muneebahmed26301/Mobile-Robot-for-Smart-Restaurants/assets/FYP - Final Defense_1.pptx

Mobile Robot for Smart Restaurants

Group Members:
Muneeb Ahmad
Ahmed Saeed
Mohib Ahmed
Muhammad Zakriya

Supervisor:
Dr. Uzair Khaleeq uz Zaman
Co-Supervisors:
Dr. Anas Bin Aqeel
A/P Kanwal Naveed

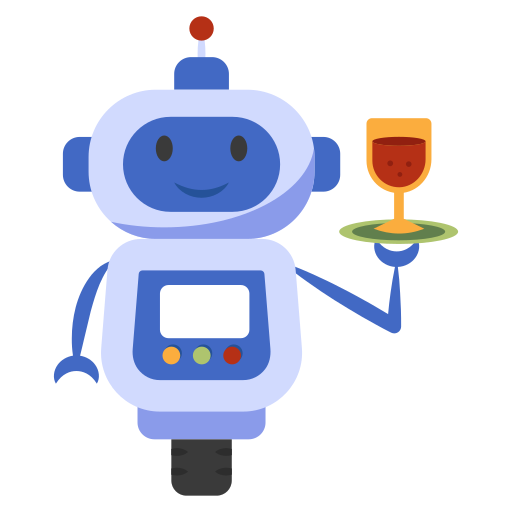
[picture p8: figure]

## Slide 2

Objective

To Design & Construct a Mobile Line Following Robot that Can Automate the Job of a Waiter In a Restaurant Environment

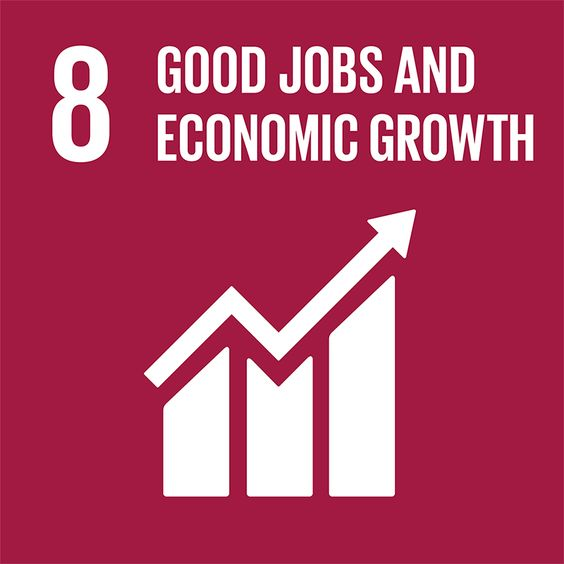
[picture p9: figure]
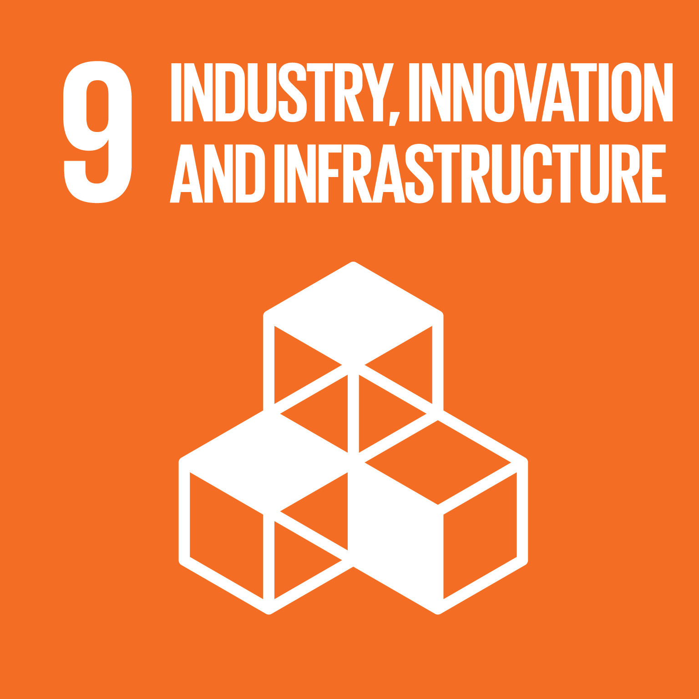
[picture p10: figure]
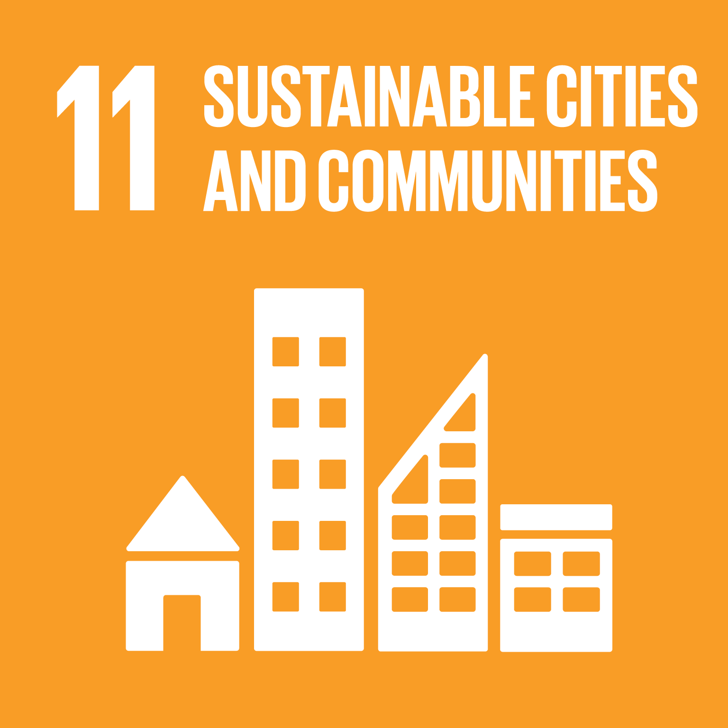
[picture p11: figure]

## Slide 3

The Problem

3.5 Trillion USD Global Restaurant Industry [1]

Labor Shortages[2] - Prime Target for Automation

Opportunities to Reduce Cost and Increase Profits[3]

Improved Customer Experience[4]

Ordering, Payment & Serving are the Easiest & Most Beneficial to Automate

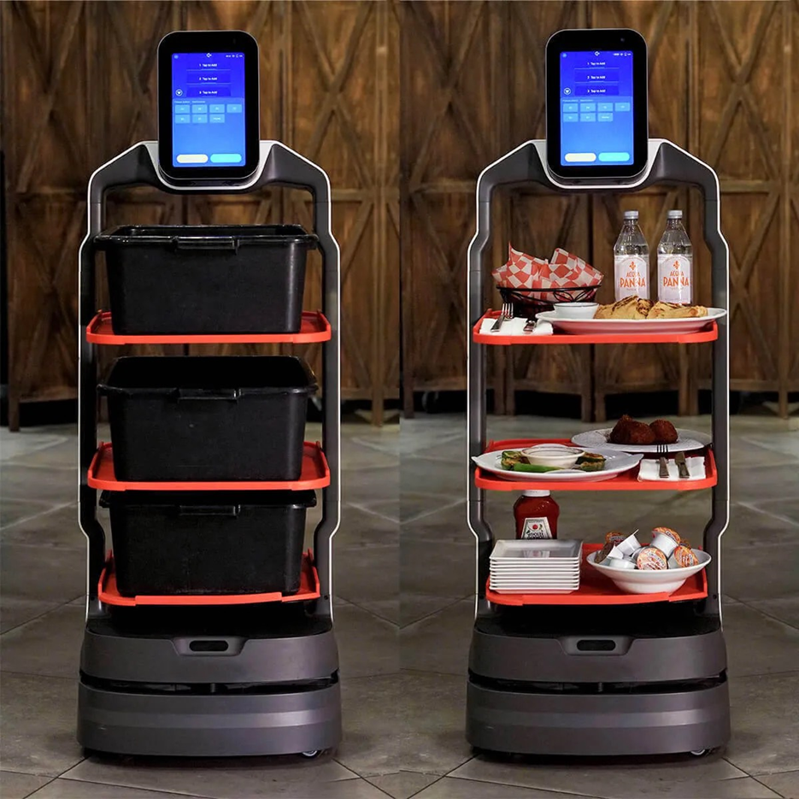
[picture p12: figure]

## Slide 4

Project Deliverables

1

Design & Build a Mobile Line Following Robot that is Able to Follow the Shortest path to a Destination (tables) and Avoid Collisions

Make it Capable of Carrying Load (Food & Drinks) without Spilling Them Using Quick Interchangeable Carrying Trays

Make it IoT Enabled so it can Send and Receive Data to and from Restaurant Staff

Ensure Ecosystem Integrability Through Software & Hardware Design as well as Industry Level Documentation

2

3

4

## Slide 5

Additional Accomplishments

5

Built An Ecosystem of Apps (Ordering, FoH Display, Remote Control) to Work Alongside the Robot as VAS

Studied Velocity, Acceleration & Braking Profiles to Ensure Robot Movement & Trajectory is Smooth and Safe

Used Cameras for Navigation Instead of a Sensor Based Approach; Enabled Robot to Map and Store the Restaurant Layout

Created a cloud Database for Restaurants to Digitize their Menus & Collect Valuable Trend Data

6

7

8

## Slide 6

Representative Environment

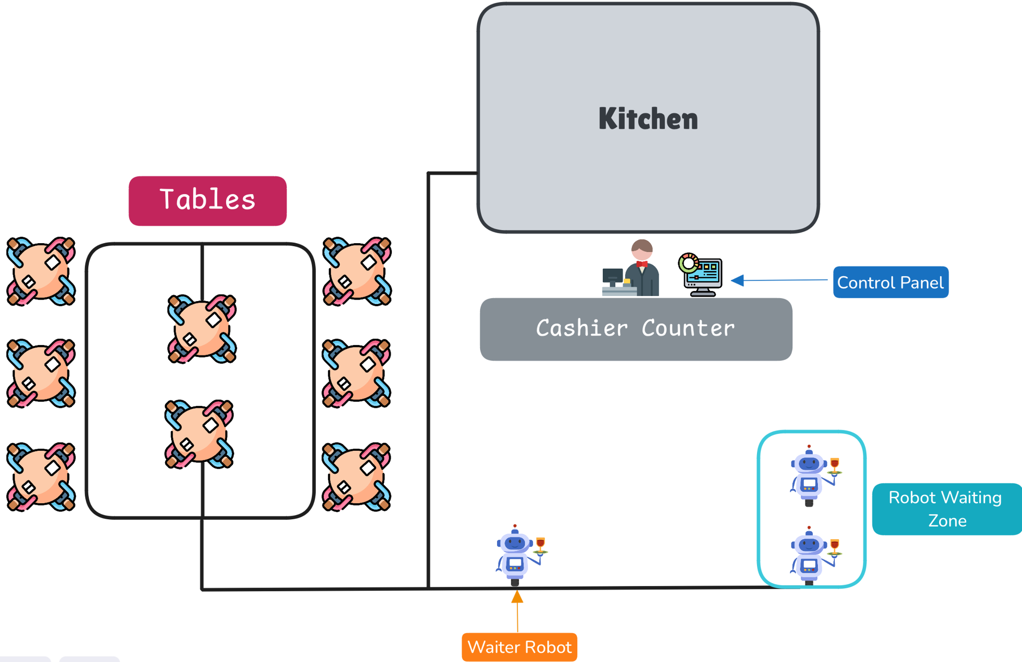
[picture p13: figure]

## Slide 7

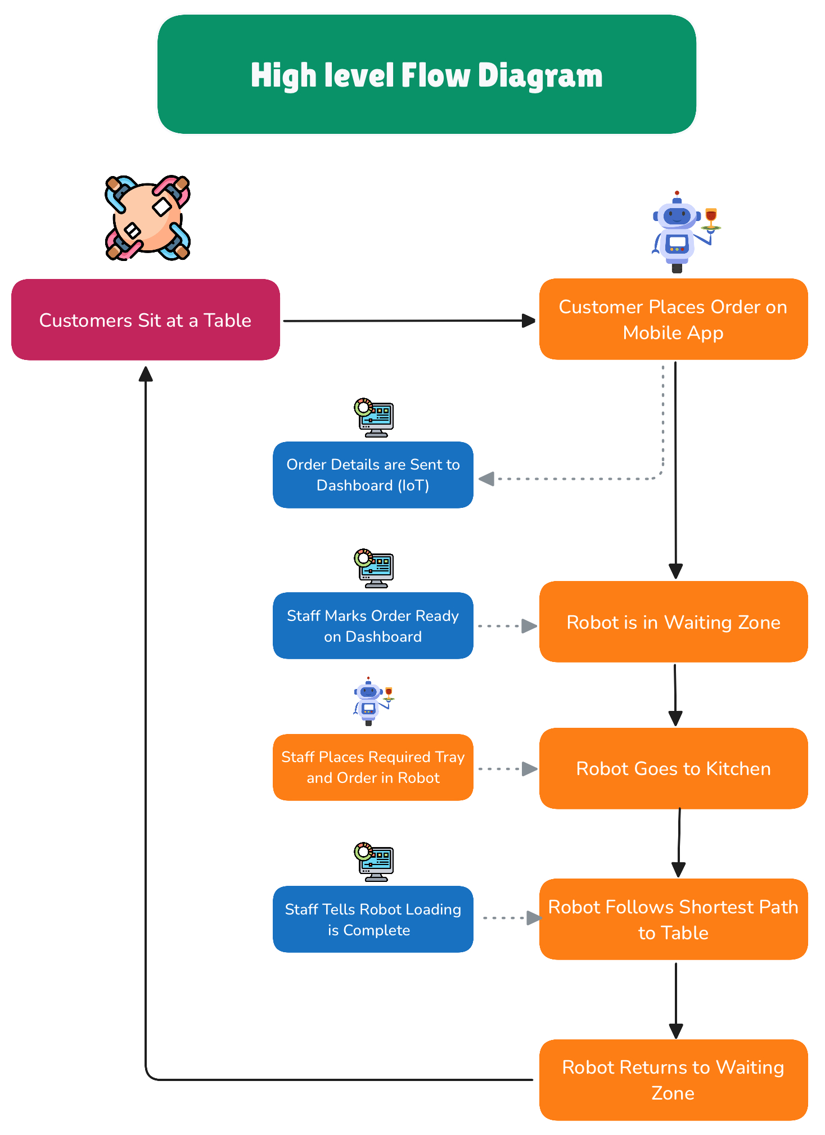
[picture p14: figure]

## Slide 8

Mechanical
Hardware

## Slide 9

Design Considerations

1

Based off Existing Designs

Design Factors Include Material availability, Safety, Cost, Strength/Load Carrying Capacity, Weight, Ease of Assembly and Aesthetics

Mechanical Simulations on ANSYS to Determine Materials & Parameters for Load Carrying or High Stress Parts

Modular Custom Parts and In House Fabrication & Assembly

2

3

4

## Slide 10

Existing Designs

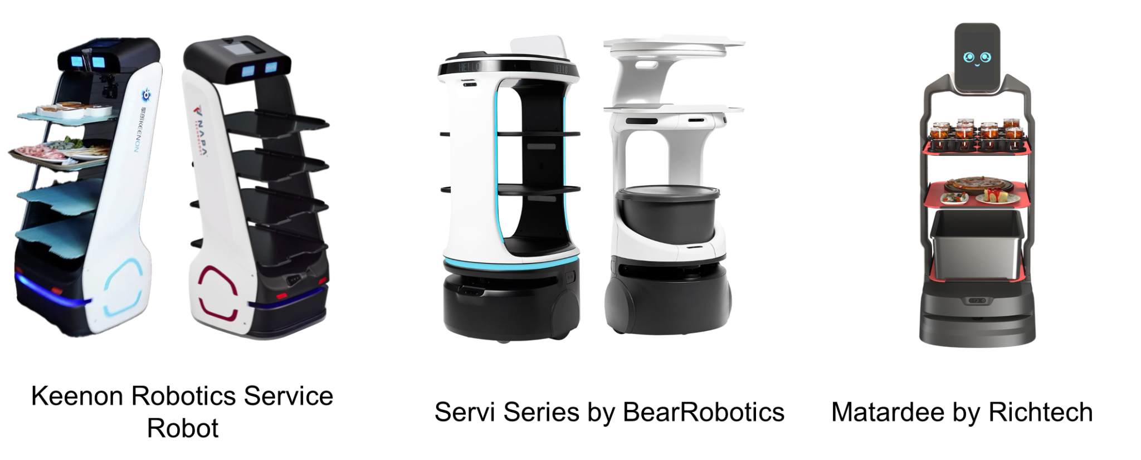
[picture p15: figure]

## Slide 11

Our Design

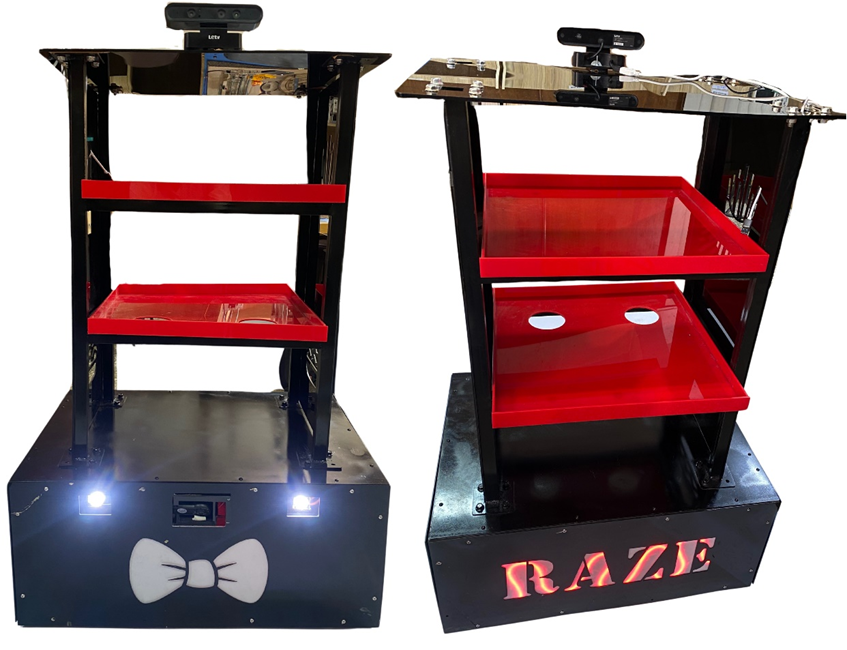
[picture p16: figure]

## Slide 12

Design Breakdown

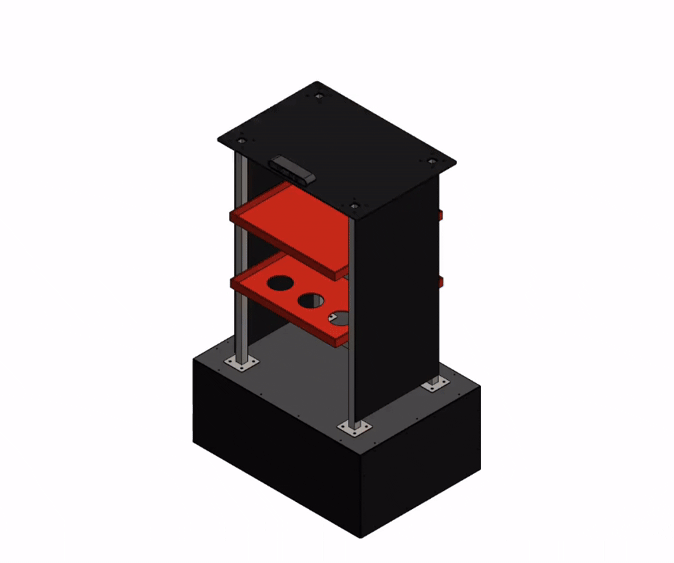
[picture p17: figure]

## Slide 13

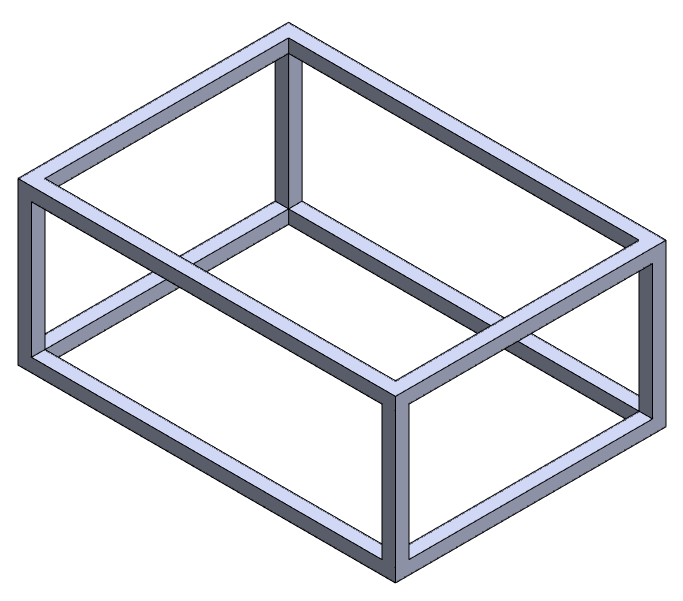
[picture p18: figure]
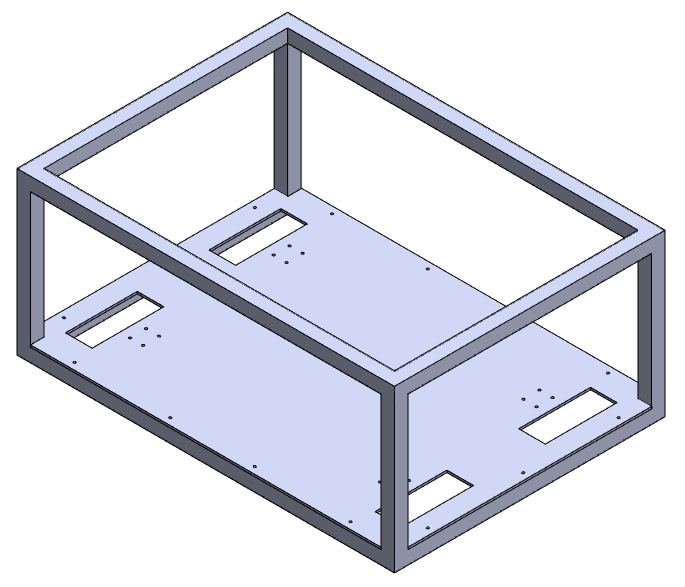
[picture p19: figure]
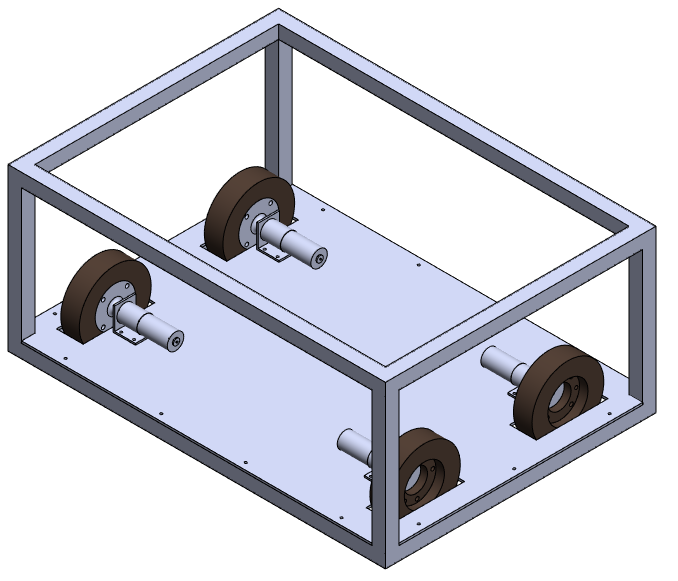
[picture p20: figure]
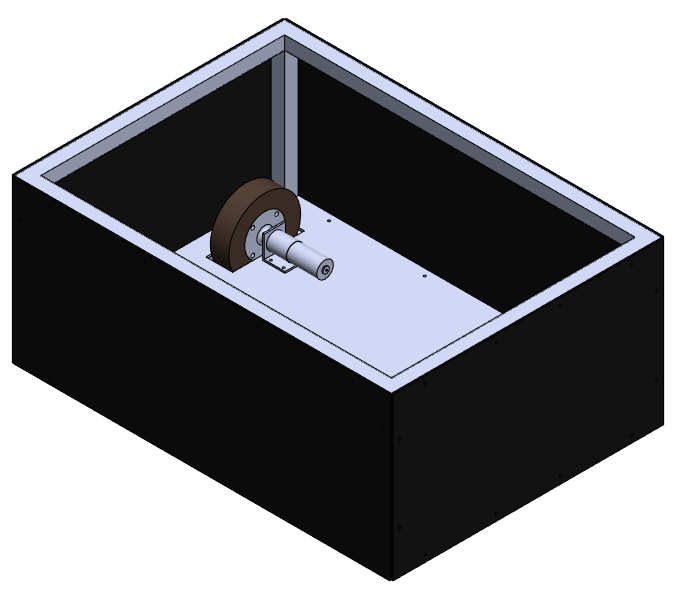
[picture p21: figure]
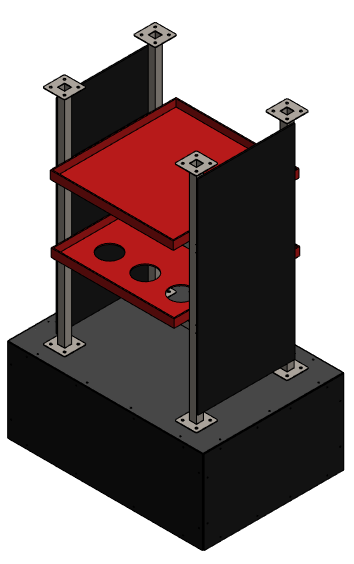
[picture p22: figure]
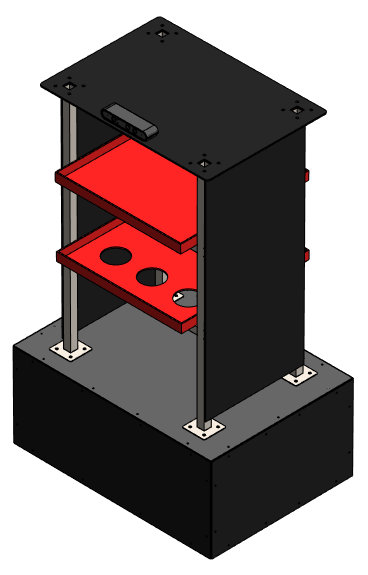
[picture p23: figure]
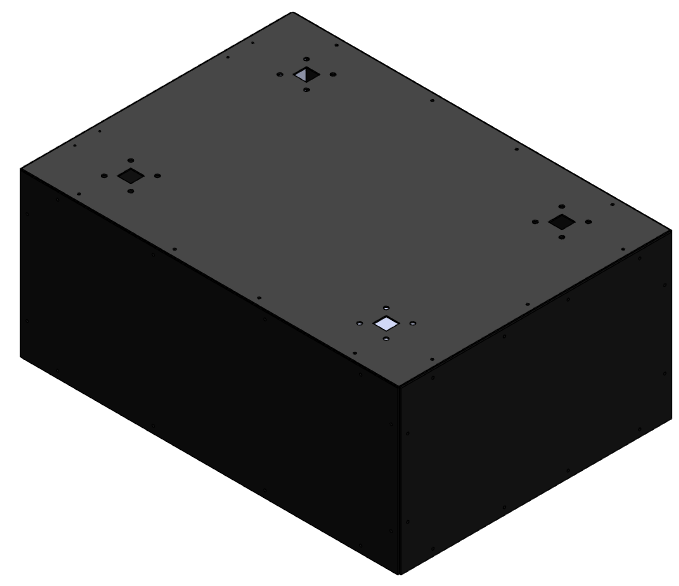
[picture p24: figure]
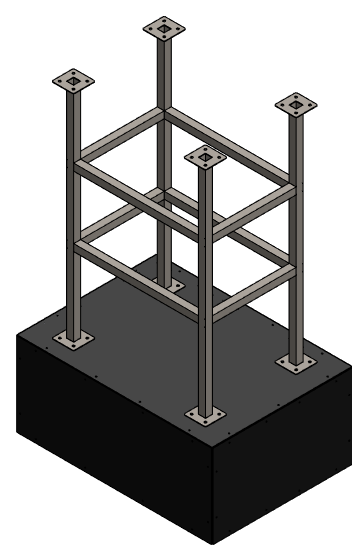
[picture p25: figure]

## Slide 14

Frame and Baseplate

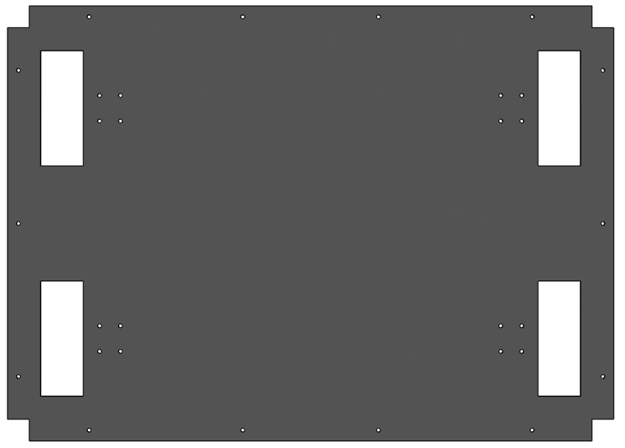
[picture p26: figure]
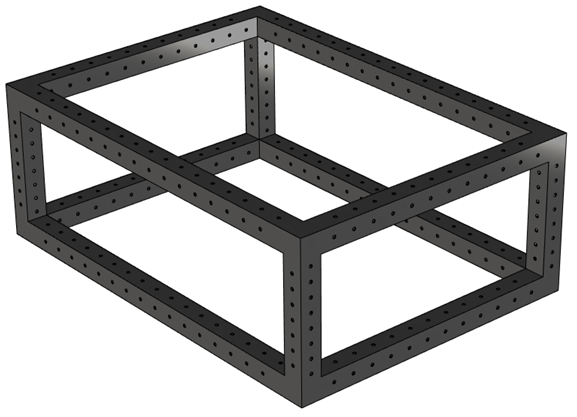
[picture p27: figure]

## Slide 15

Frame and Baseplate

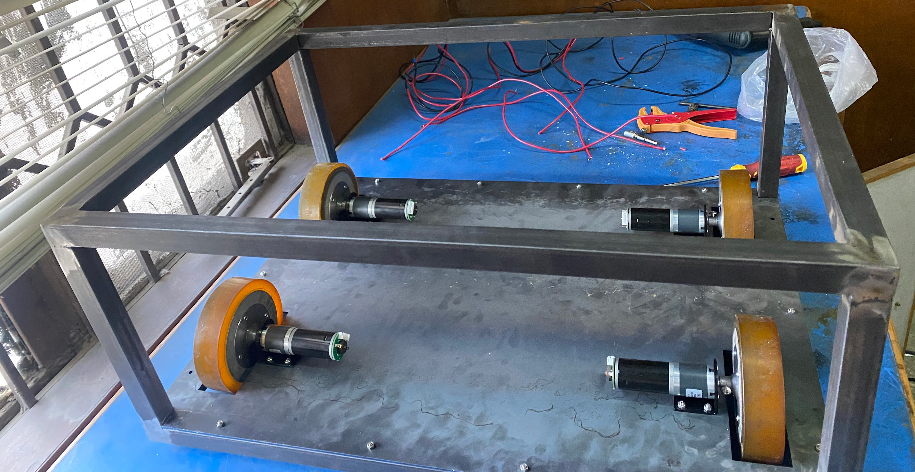
[picture p28: figure]
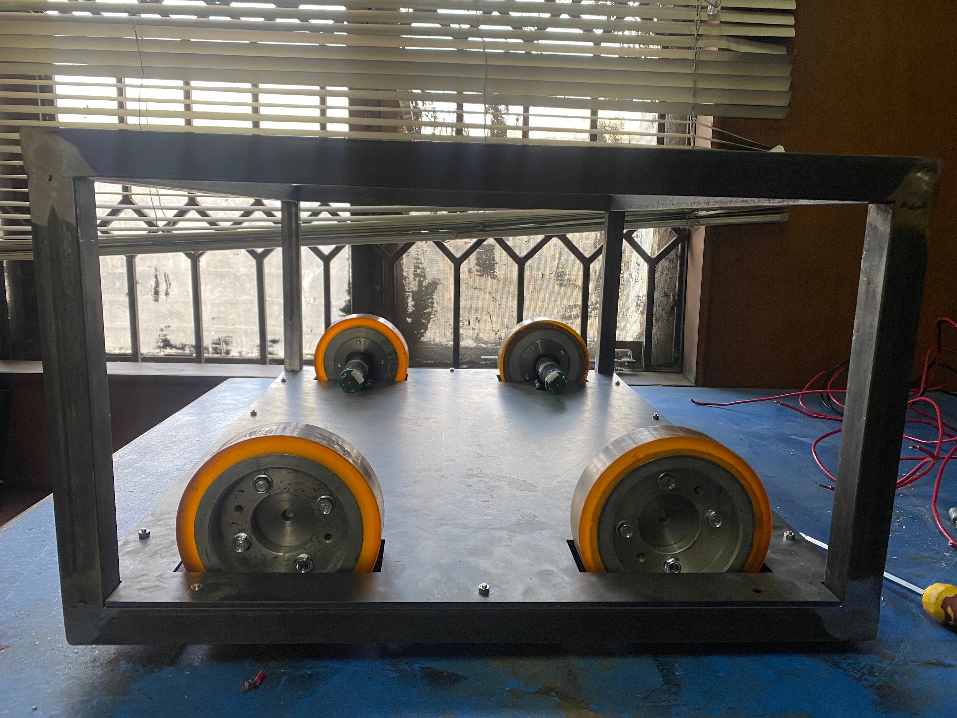
[picture p29: figure]

## Slide 16

Couplers and Wheels

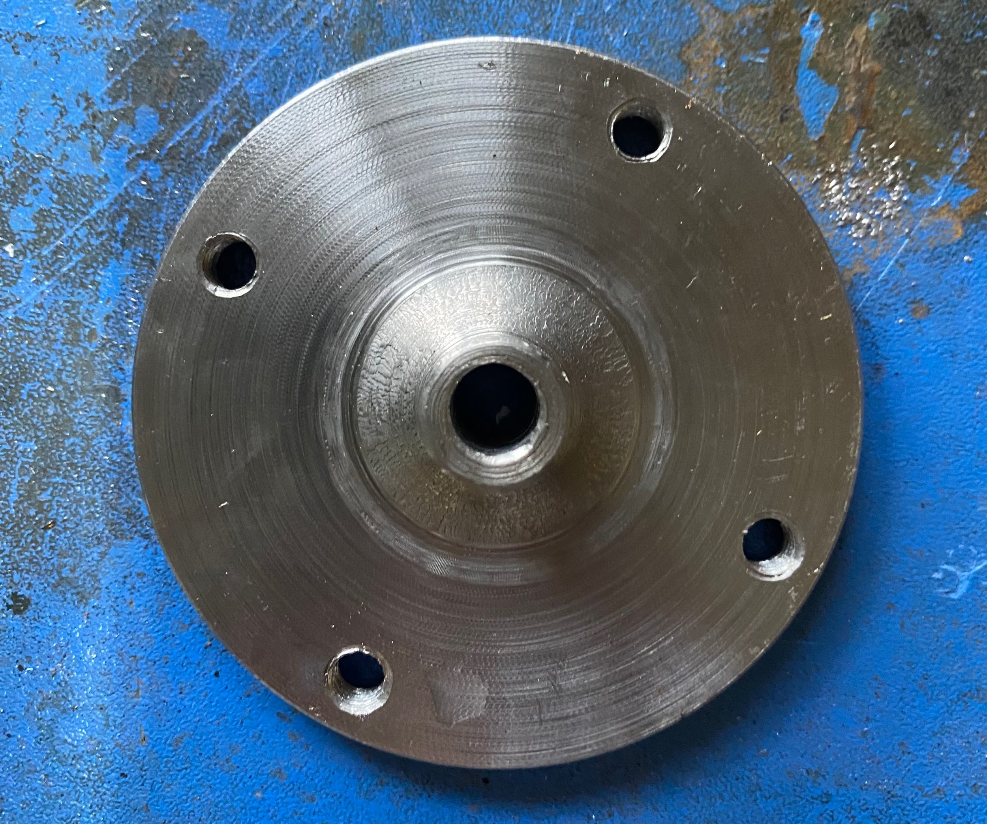
[picture p30: figure]
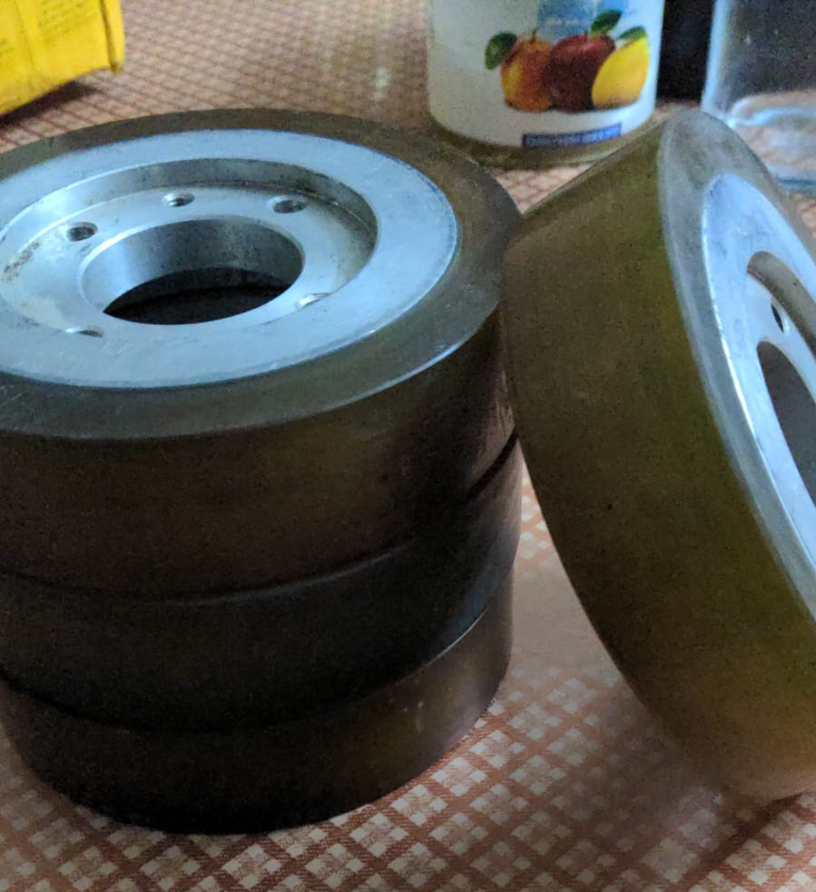
[picture p31: figure]

## Slide 17

Coupler Deformation

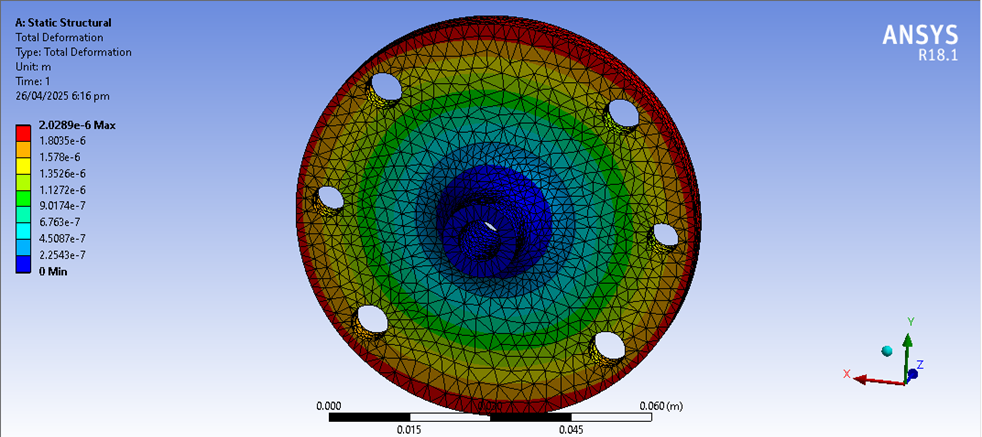
[picture p32: figure]

## Slide 18

Coupler Stress

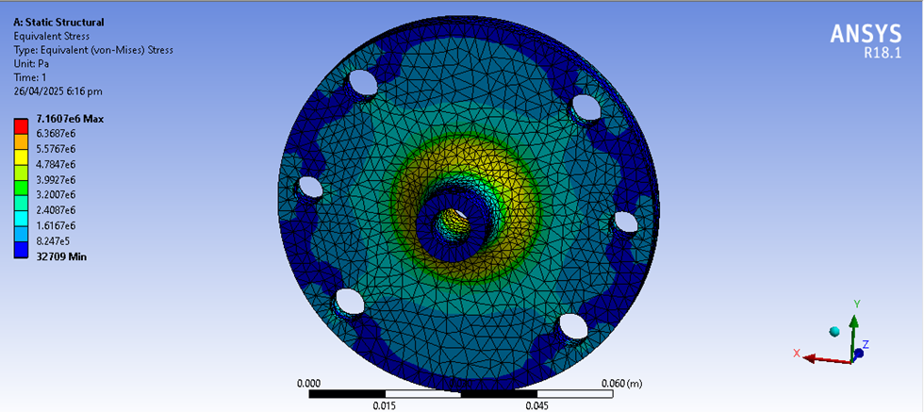
[picture p33: figure]

## Slide 19

Load Trays

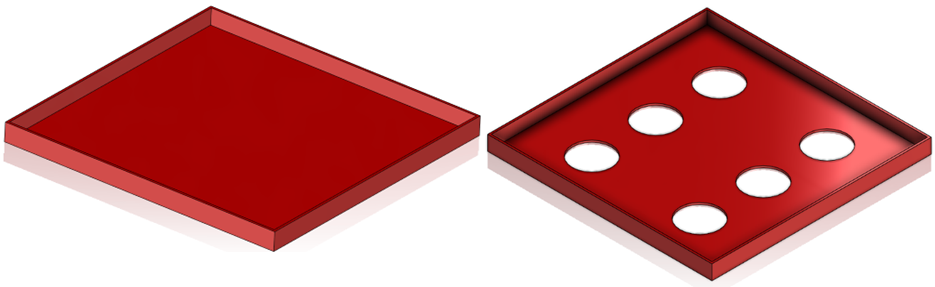
[picture p34: figure]

## Slide 20

Load Trays Deformation

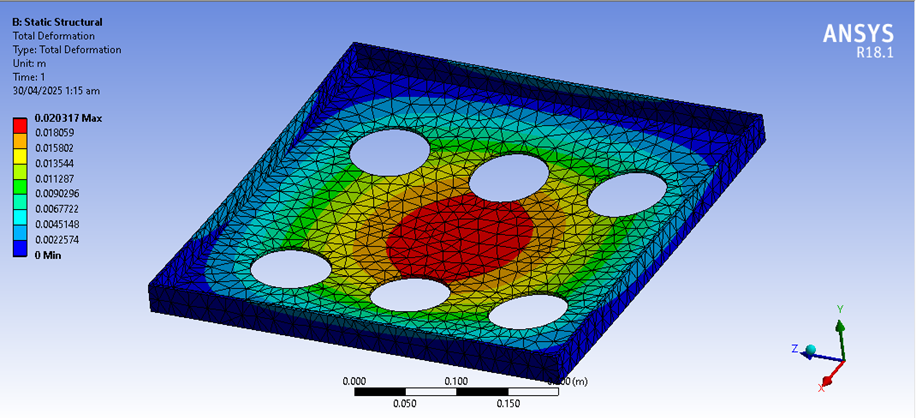
[picture p35: figure]

## Slide 21

Electrical
Hardware

## Slide 22

Electrical Design Highlights

1

Electronics are Mostly off the Shelf Components; Easy access and Replacement

Selection & Acquisition of Electrical Hardware was done on the Basis of Mechanical Requirements

Electrical Safety, Redundancy & Modularity Ensured

Dual Batteries With Built-in Charger & Charge Indicator

2

3

4

## Slide 23

Wiring Layout

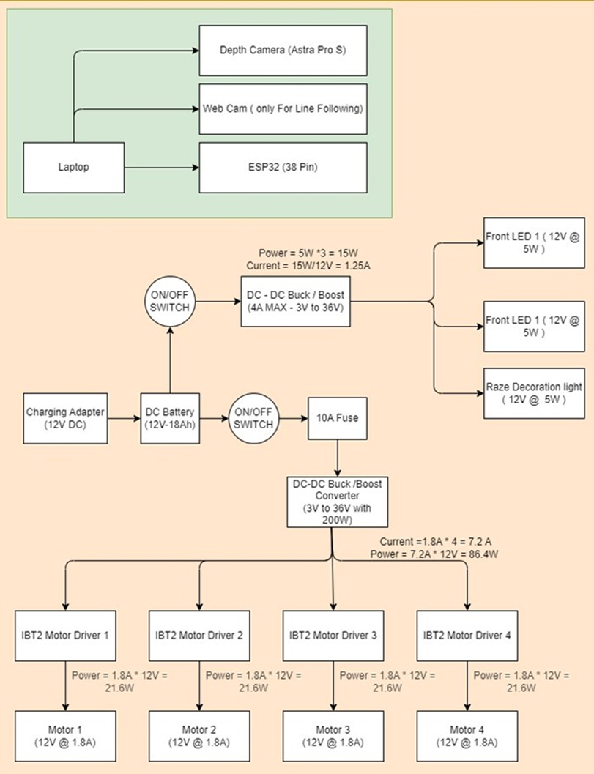
[picture p36: figure]

## Slide 24

Connections Layout

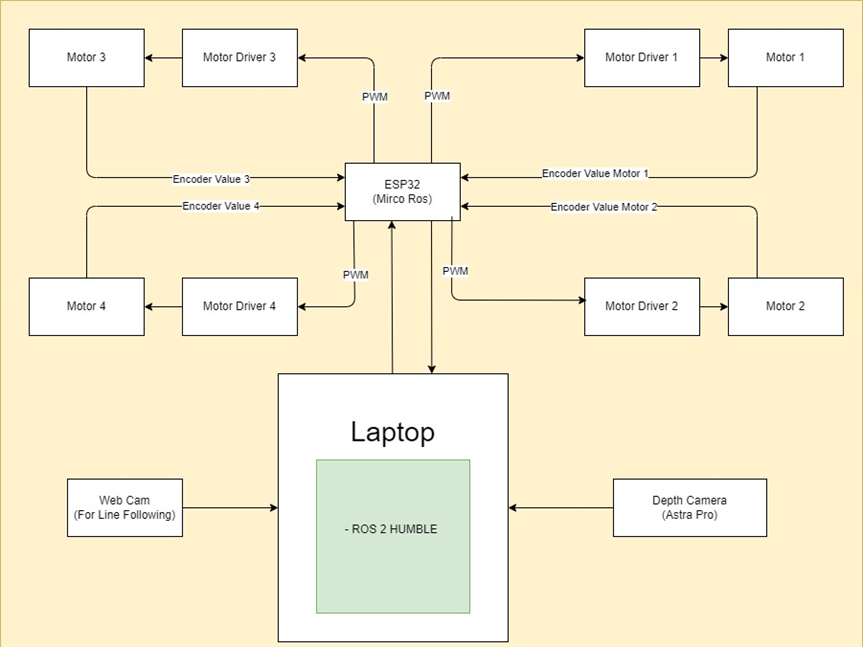
[picture p37: figure]

## Slide 25

Motors and Drivers

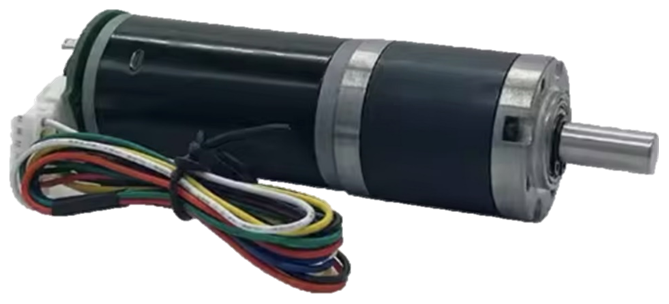
[picture p38: figure]

Reduction Ratio | No Load Ratings | | | Loaded Ratings | | | | Stall Ratings
| Voltage | Speed | Current | Speed | Current | Torque | Power | Torque | Current
71 | 12 V | 112 RPM | 0.45 A | 90 RPM | 1.8 A | 10 kg cm | 21.6 W | 33 kg cm | 5 A

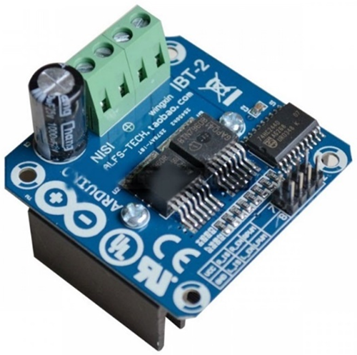
[picture p39: figure]

## Slide 26

Batteries

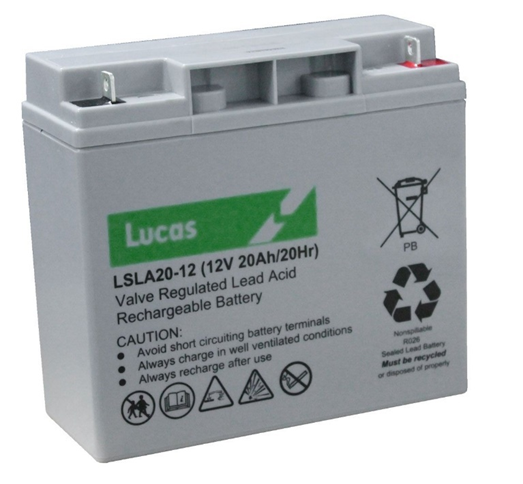
[picture p40: figure]

Voltage | Capacity | Max Current | Battery Timing | Charge Time
12 V | 28 + 3 Ah | 20A | 6-10 Hours | 4 Hours

## Slide 27

Controller

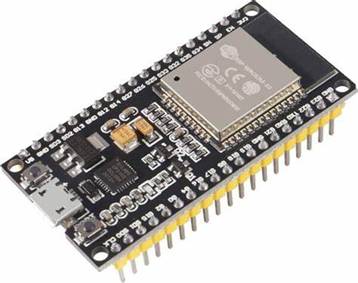
[picture p41: figure]

Controller | Clock Speed | Voltage | GPIO Pins | Analog Inputs | PWM Pins | UART / I2C / SPI | Wi-Fi | Bluetooth | Flash Memory | RAM | USB Interface | Price (Approx.)
Dual-core Tensilica LX6 | Up to 240 MHz | 3.3V | 34 | 18 (12-bit ADC) | Most GPIOs | 3 / 2 / 4 | Yes | Yes | 4MB (external) | ~520KB SRAM | Micro USB | $5–10

## Slide 28

Feature | ESP32 NodeMCU | Arduino Uno | Arduino Mega | RPi Pico
Microcontroller | Dual-core Tensilica LX6 | ATmega328P | ATmega2560 | Dual-core ARM Cortex-M0+
Clock Speed | Up to 240 MHz | 16 MHz | 16 MHz | 133 MHz
Voltage | 3.3V | 5V | 5V | 3.3V
GPIO Pins | 34 | 14 (6 PWM) | 54 (15 PWM) | 26
Analog Inputs | 18 (12-bit ADC) | 6 (10-bit ADC) | 16 (10-bit ADC) | 3 (12-bit ADC)
PWM Pins | Most GPIOs | 6 | 15 | All GPIOs
UART / I2C / SPI | 3 / 2 / 4 | 1 / 1 / 1 | 4 / 1 / 1 | 2 / 2 / 2
Wi-Fi | Yes | No | No | No
Bluetooth | Yes | No | No | No
Flash Memory | 4MB (external) | 32KB | 256KB | 2MB
RAM | ~520KB SRAM | 2KB | 8KB | 264KB
USB Interface | Micro USB | USB-B | USB-B | Micro USB
Price (Approx.) | $5–10 | $10–20 | $25–35 | $4–8

## Slide 29

Camera

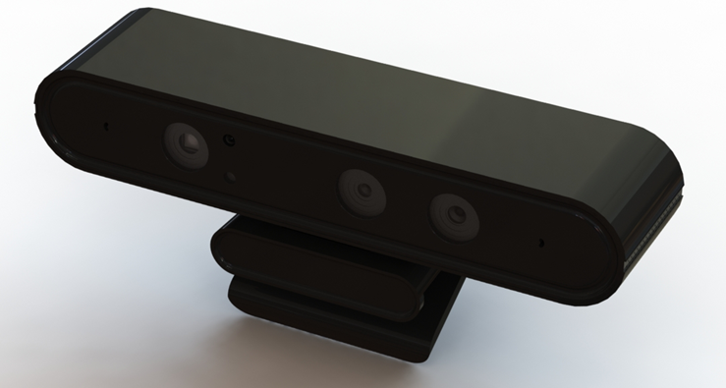
[picture p42: figure]

Depth Sensing Range | Depth Resolution | RGB Resolution | FoV | Operating Systems | SDK Support
0.6 to 8 meters | 640×480 at 30 FPS | 1280×720 at 30 FPS | 60° horizontal × 49.5° vertical × 73° diagonal | Windows, Linux, Android | OpenNI, Astra SDK, ROS.

## Slide 30

Ecosystem Applications

## Slide 31

Ecosystem Highlights

1

A System of Supporting Flutter Apps Built around the Robot to act as VaS

An Ordering App That Can be Installed on Customers’ Phones, Tablets or Used Directly from the Robot

A Dashboard App Installed in the Kitchen and Cashier Stations; Allows for tracking of Orders and their Updating their Statuses

A Remote Control App That Allows Manual Control Over the Robot from a Device by Authorized Users

Databases that Allow Restaurants to Digitize their Menus and Collect Valuable Customer Data & Trends

2

3

4

5

## Slide 32

Ordering App

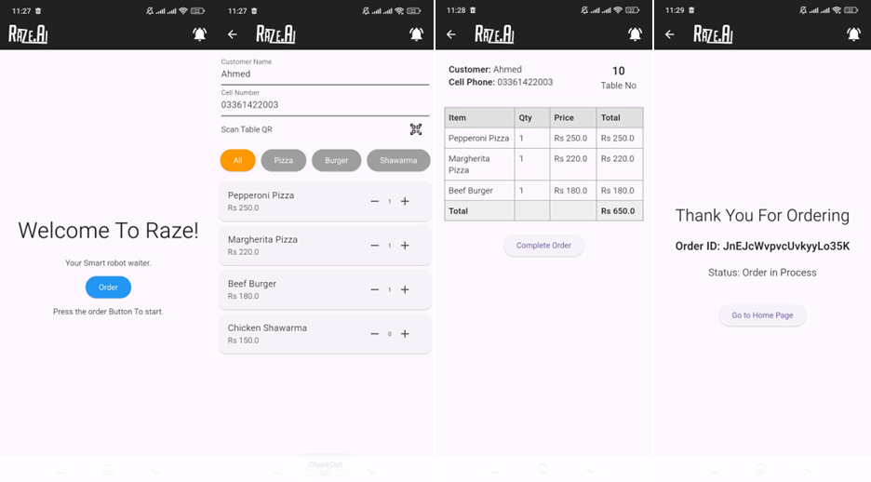
[picture p43: figure]

## Slide 34

Dashboard App

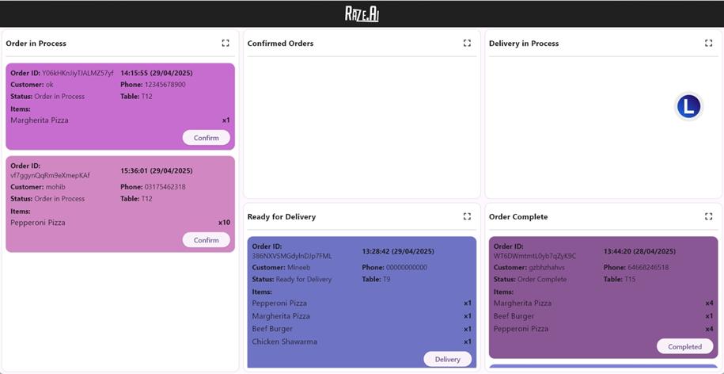
[picture p44: figure]

## Slide 35

Dashboard App

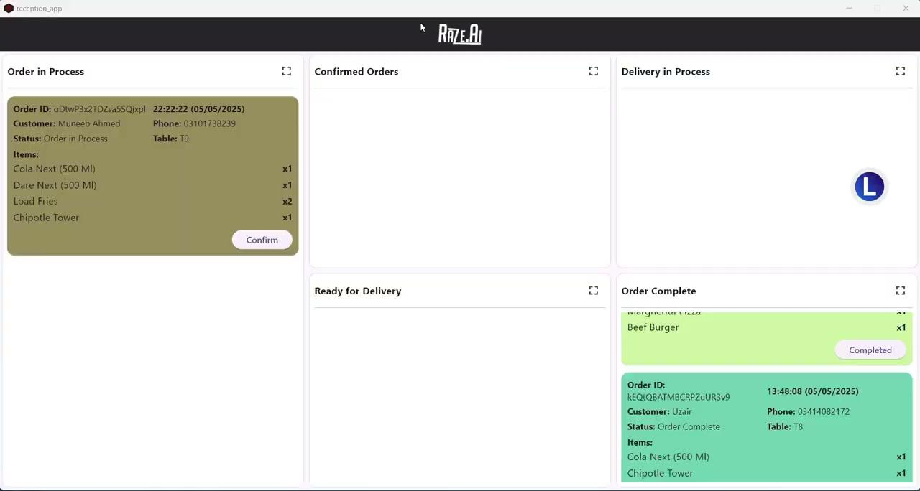
[picture p45: figure]

## Slide 36

Remote Control App

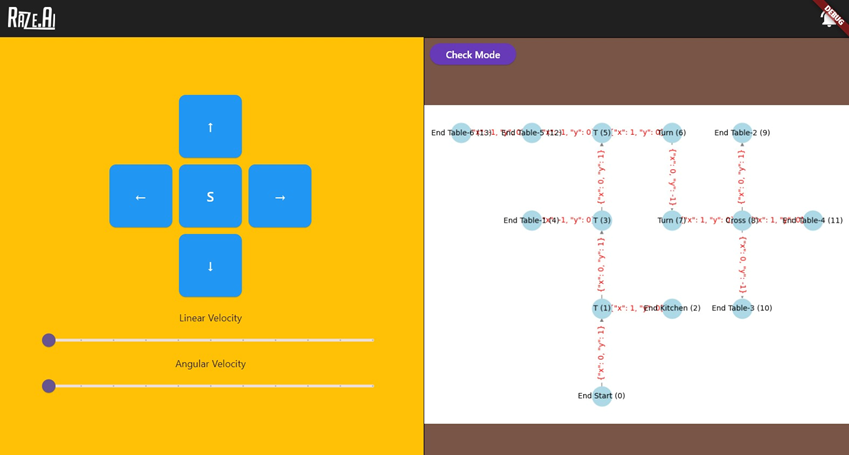
[picture p46: figure]

## Slide 37

Remote Control App

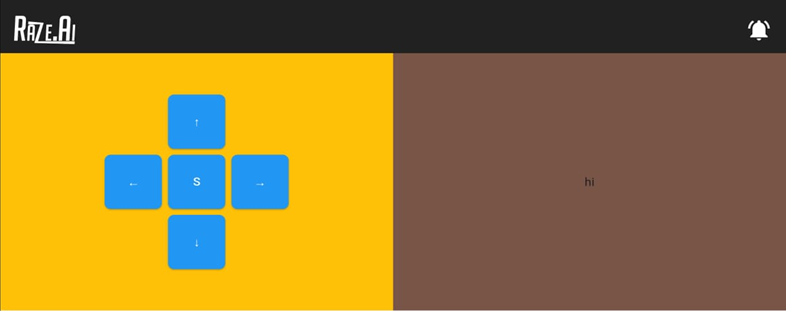
[picture p47: figure]

Webcam Feed

## Slide 38

RC App Video

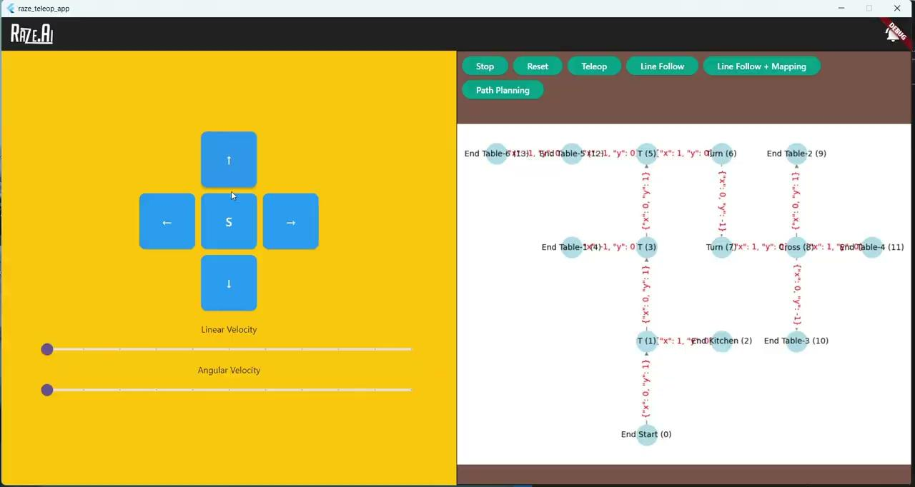
[picture p48: figure]

Webcam Feed

## Slide 39

Simulations & Navigation

## Slide 40

URDF & Kinematics

Created URDF Files from CAD Model, Calculated Forward & Inverse Kinematics of the Robot

Simulated and integrated the Robot, Environment and Cameras in Gazebo Using ROS2 and the Kinematics

Simulation First Approach Allowed for Easy Debugging and Testing Before Robot was Even Assembled

1

2

3

## Slide 41

Robot Model Using URDF & Kinematics

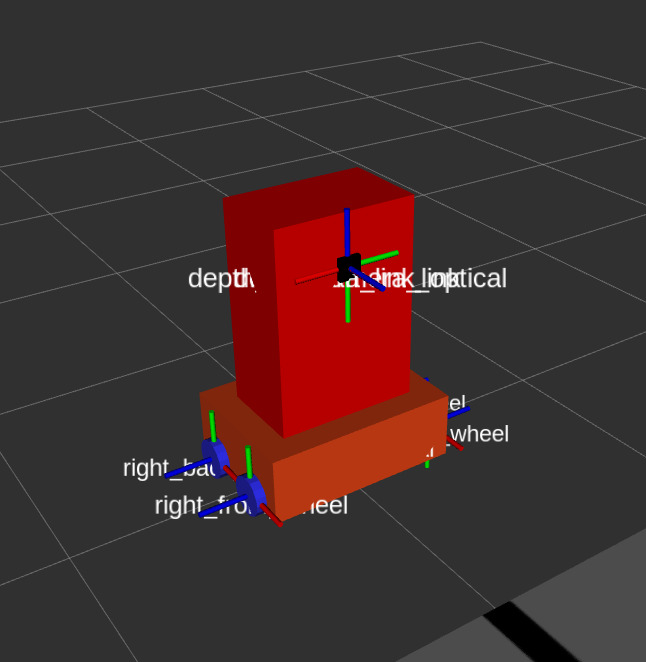
[picture p49: figure]
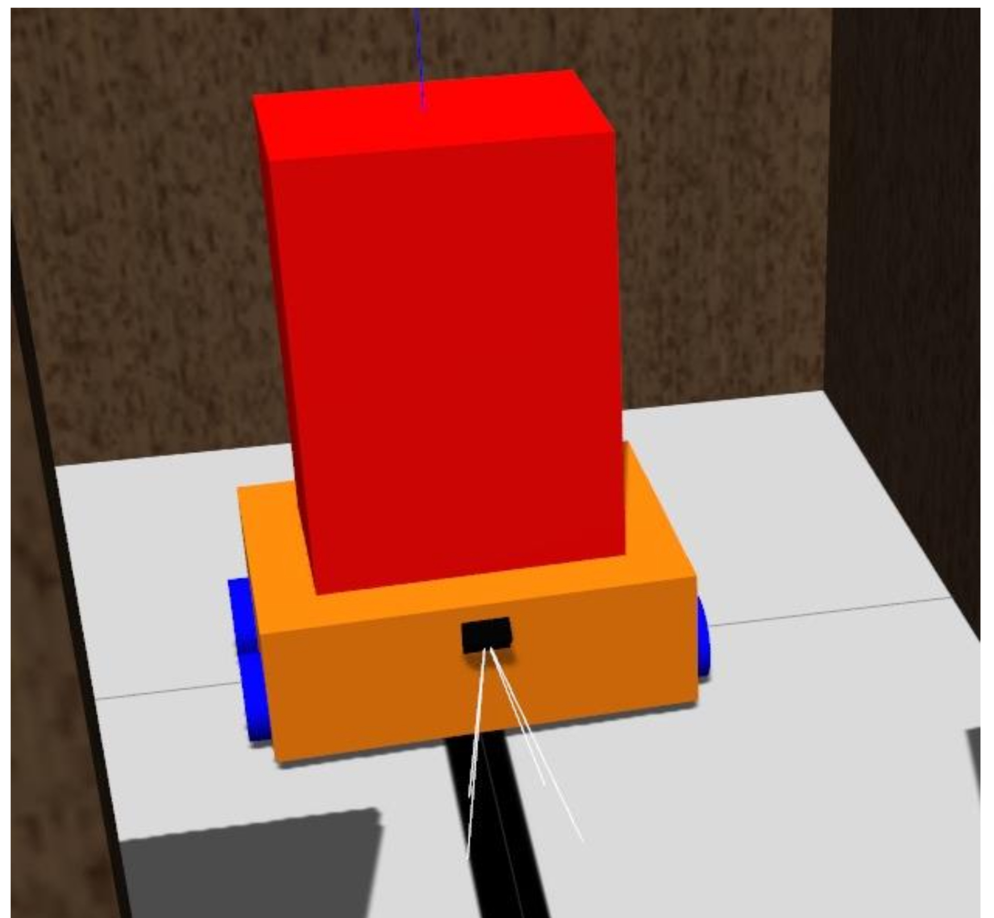
[picture p50: figure]

## Slide 42

Modeling the Environment

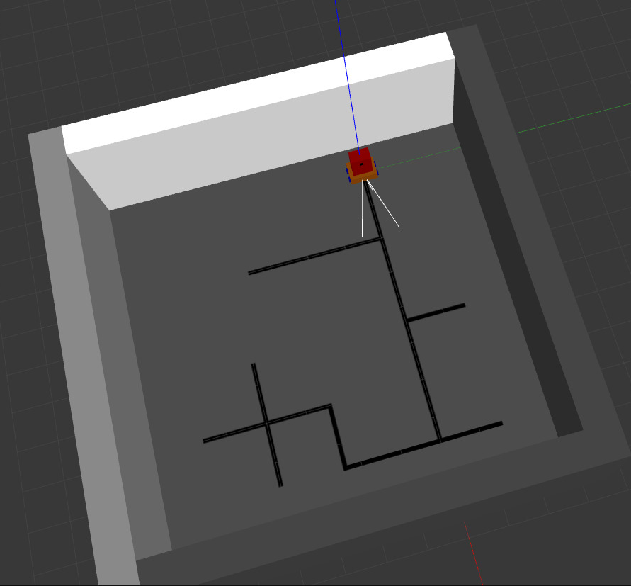
[picture p51: figure]
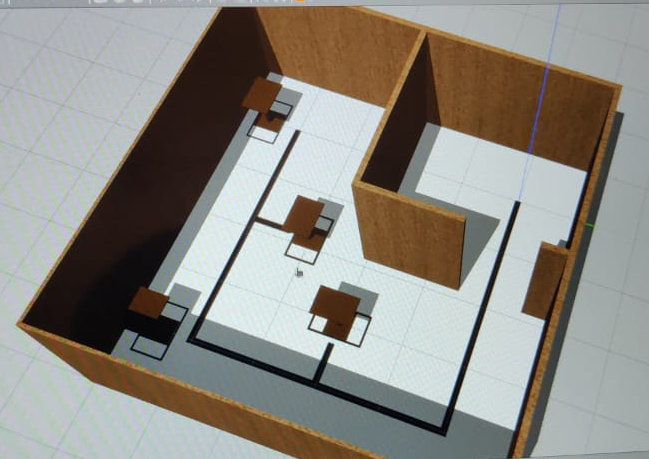
[picture p52: figure]

## Slide 43

Velocity Profiles

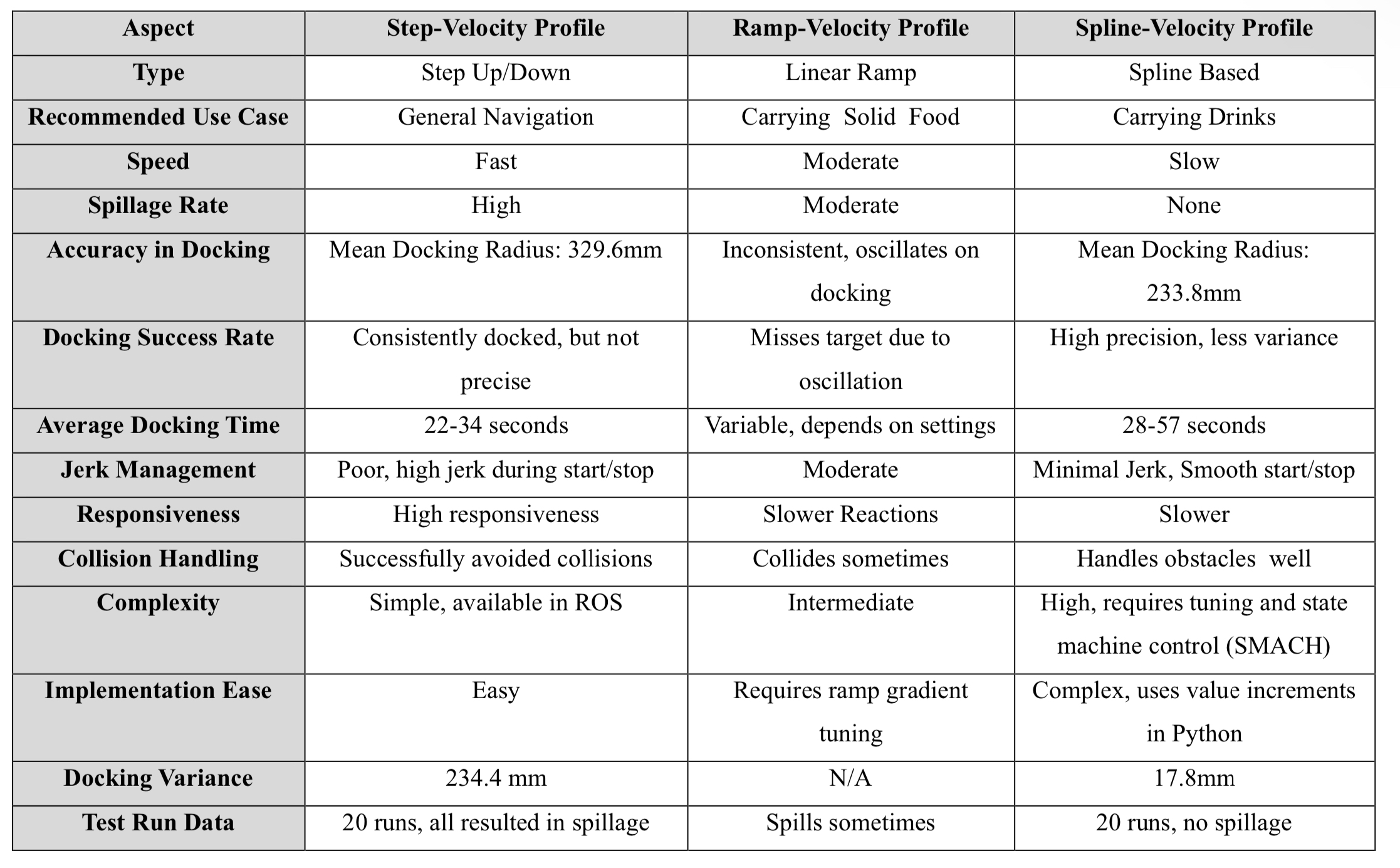
[picture p53: figure]

## Slide 44

URDF Code

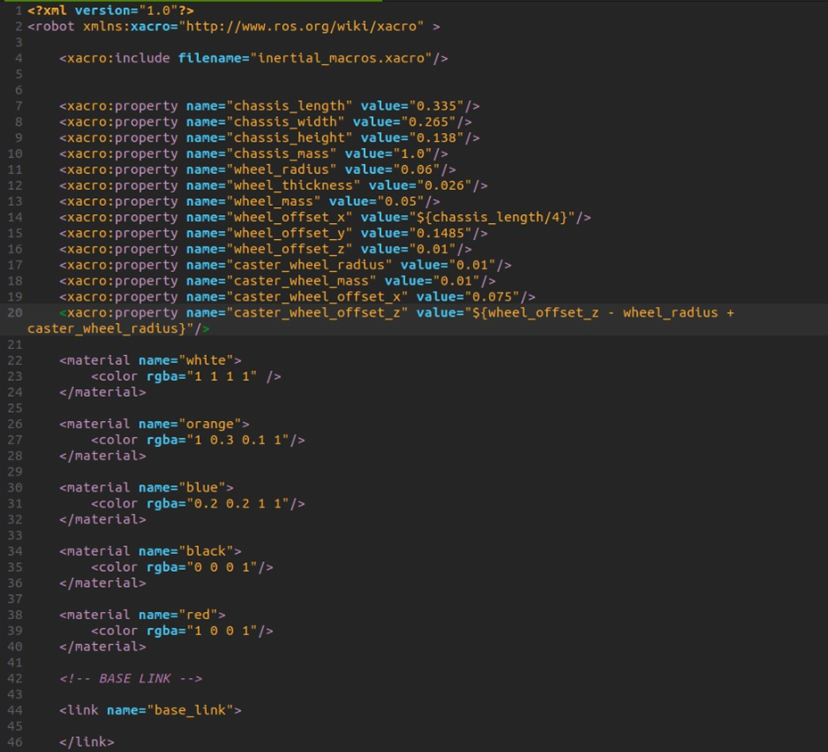
[picture p54: figure]

## Slide 45

Kinematics Code

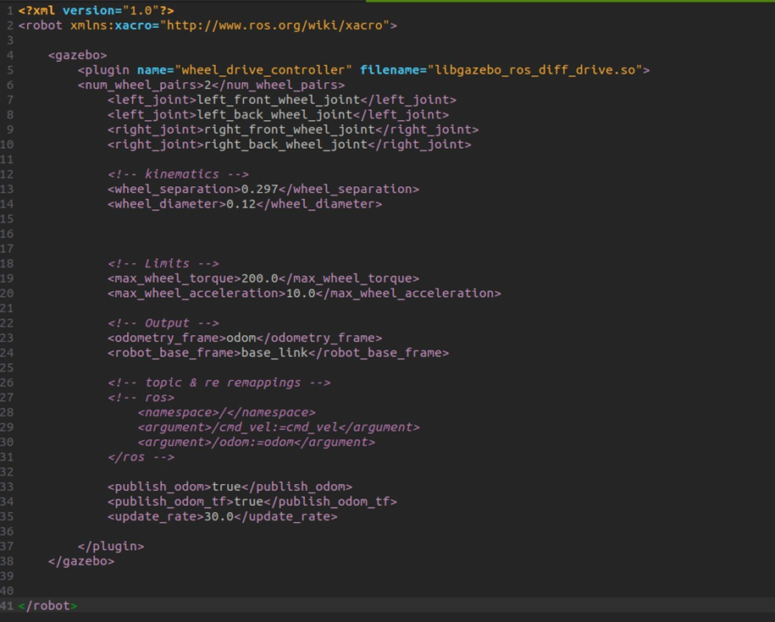
[picture p55: figure]

## Slide 46

Navigation

1

Created a Robust Line Identification and Tracking Algorithm Using OpenCV

Performed Junction Classification Using ArUco Markers

2

Created a Mapping and Path Planning Algorithm

Used Depth Camera to Detect Obstacles and Avoid Collisions

3

4

## Slide 47

Line Following Algorithm

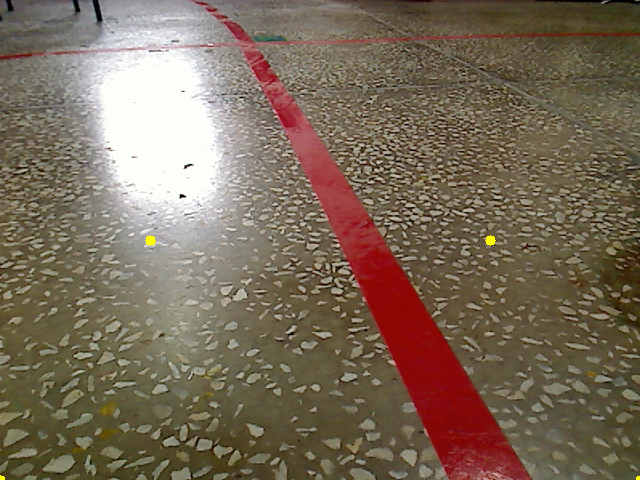
[picture p56: figure]
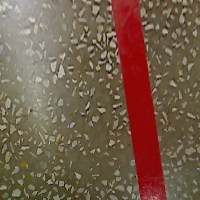
[picture p57: figure]
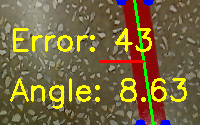
[picture p58: figure]

## Slide 48

Junction Classification

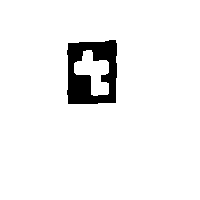
[picture p59: figure]
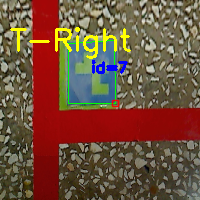
[picture p60: figure]

## Slide 49

Mapping & Path Planning

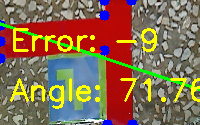
[picture p61: figure]
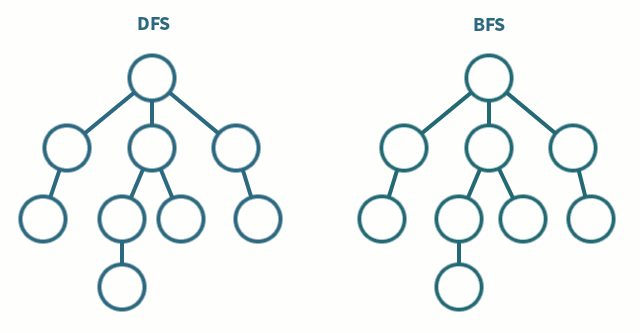
[picture p62: figure]
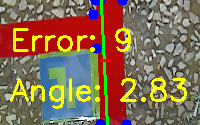
[picture p63: figure]
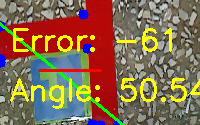
[picture p64: figure]

## Slide 50

Collision Avoidance

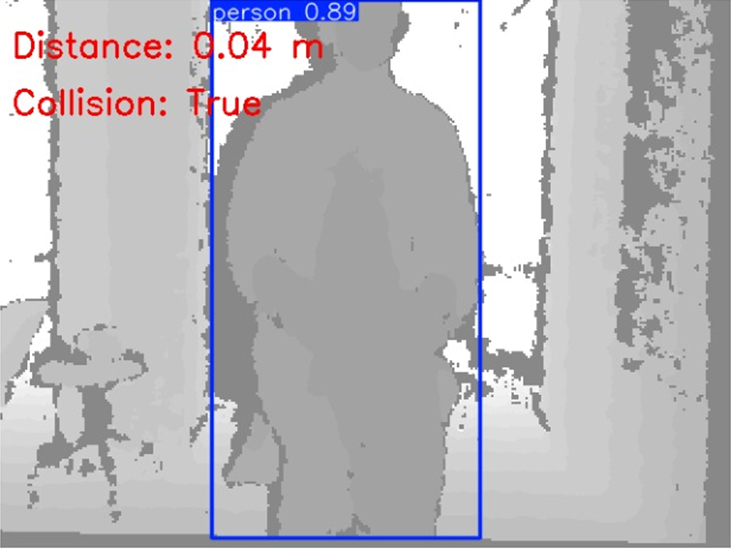
[picture p65: figure]

## Slide 51

Line Identification

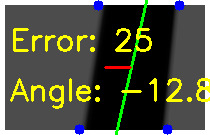
[picture p66: figure]
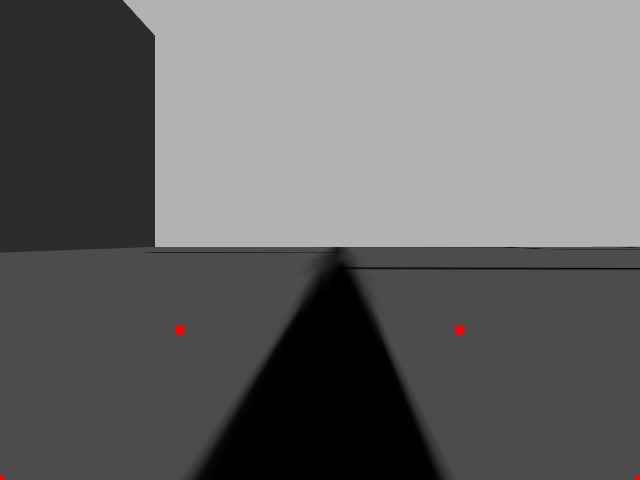
[picture p67: figure]
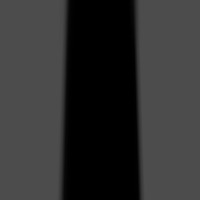
[picture p68: figure]

## Slide 52

Junction Identification

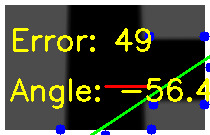
[picture p69: figure]
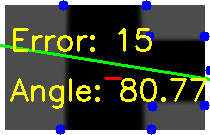
[picture p70: figure]

## Slide 53

Line Map

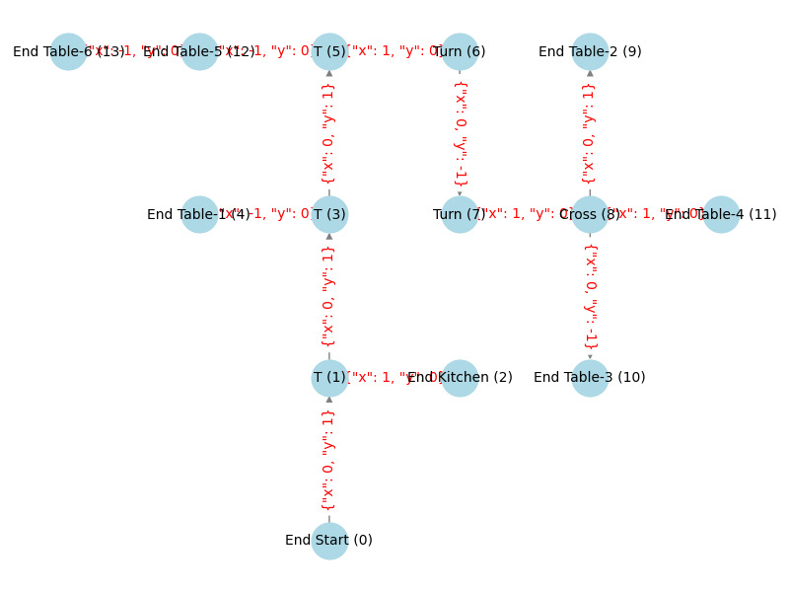
[picture p71: figure]

## Slide 54

Results &
Conclusions

## Slide 55

Testing Results

| No. of Tests in Final Configuration | Successful Runs (Navigated & Delivered) | Partial Failures | | Failed Runs
| | | Navigated but did not deliver | Delivered but did not navigate
With Only Food | 10 | 9 | 0 | 1 | 0
With Only Drinks | 10 | 9 | 1 | 0 | 0
With Food & Drinks | 10 | 10 | 0 | 0 | 0
Total | 30 | 28 (93.33%) | 1 | 1 | 0

## Slide 56

Limitations

1

Scope Constraints; Lack of Realistic Testing Environment & Dependance On Structured Environment

Component Availability & Cost Issues, Delivery Issues from Foreign Suppliers

2

Hesitation to Testing & Adoption, Especially by Local Restaurant Owners

Lack of Long Term Performance Data (Customer Trends, Battery Data, Wear & Tear Data)

3

4

## Slide 57

Future Work

1

Transition To Full Autonomy Via SLAM

Real Time Path Re-Planning & Dynamic Obstacle Avoidance

2

Multi Robot Integration & Fleet Management Operations

Design Optimizations; Charging Dock, PoS Integration, Moveable Trays, Voice Commands, Advanced UI & Language Support

3

4

## Slide 58

Thank You

## Slide 59

Questions?
