muneebahmed26301/Mobile-Robot-for-Smart-Restaurants/assets/Robot-main-body.png

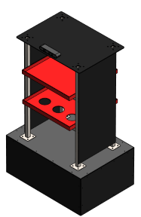
assets/Robot-main-body.png
