muneebahmed26301/Mobile-Robot-for-Smart-Restaurants/model_train/confusion_matrix.png

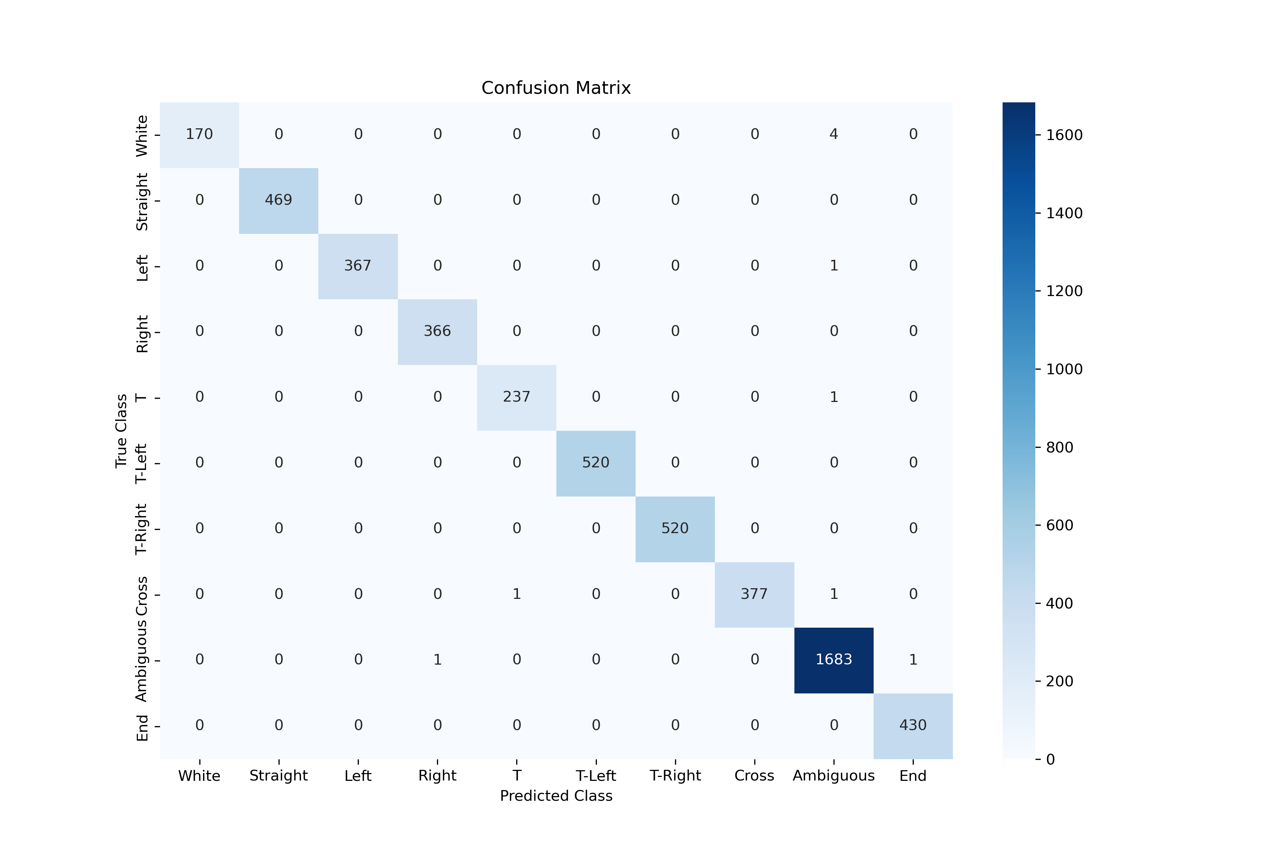
model_train/confusion_matrix.png
