muneebahmed26301/Mobile-Robot-for-Smart-Restaurants/model_train/runs/classify/train2/train_batch1.jpg

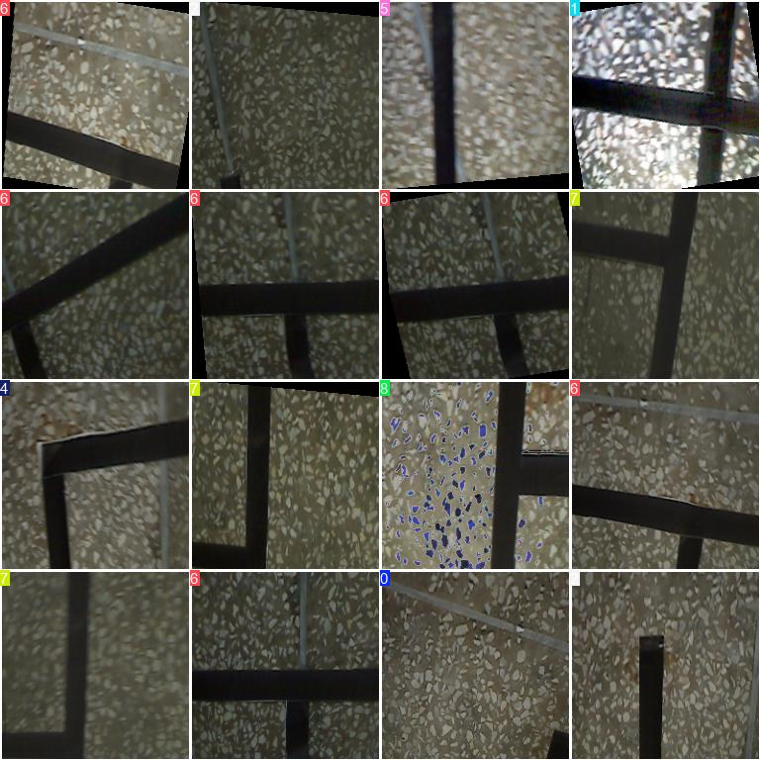
model_train/runs/classify/train2/train_batch1.jpg
