muneebahmed26301/Mobile-Robot-for-Smart-Restaurants/model_train/runs/classify/train/confusion_matrix.png

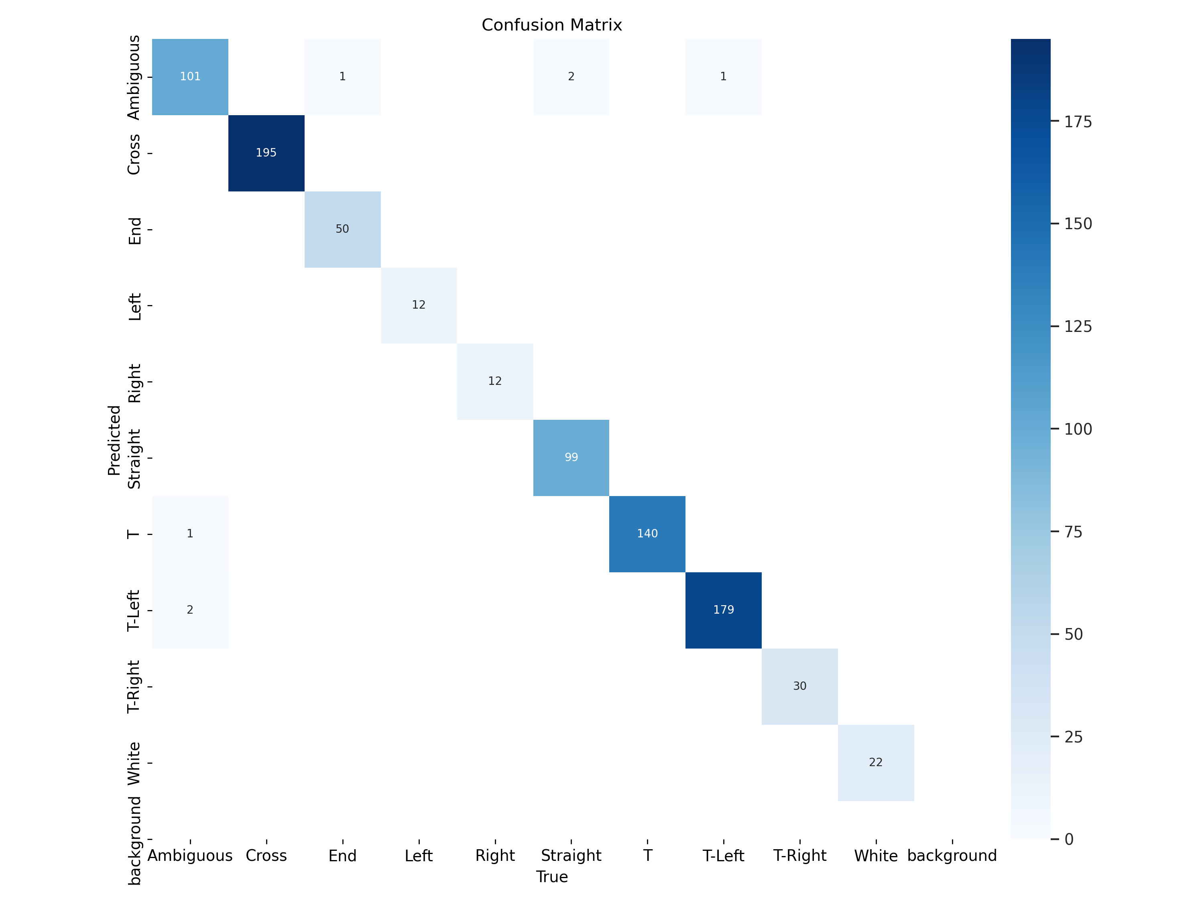
model_train/runs/classify/train/confusion_matrix.png
