muneebahmed26301/Mobile-Robot-for-Smart-Restaurants/model_train/runs/classify/train/train_batch2.jpg

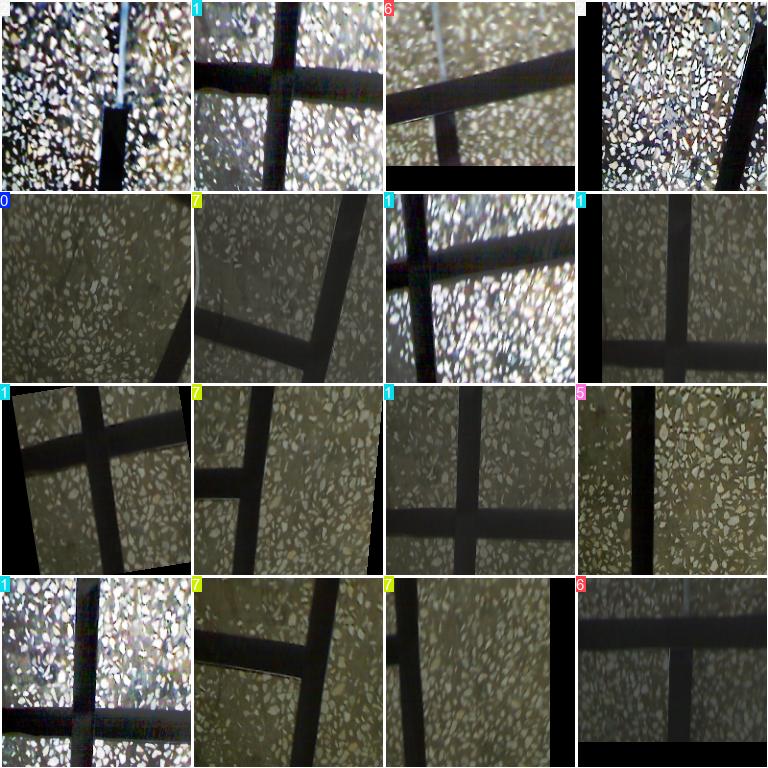
model_train/runs/classify/train/train_batch2.jpg
