muneebahmed26301/Mobile-Robot-for-Smart-Restaurants/model_train/runs/classify/train/val_batch0_pred.jpg

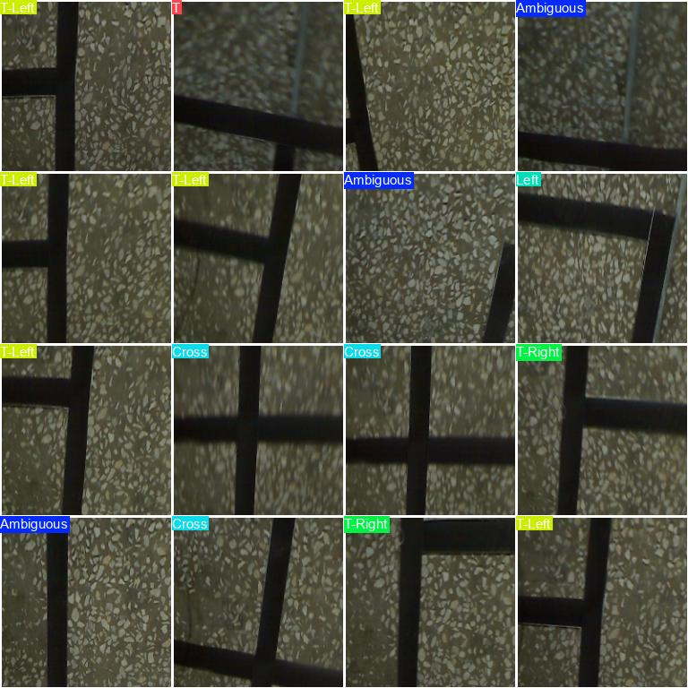
model_train/runs/classify/train/val_batch0_pred.jpg
