muneebahmed26301/Mobile-Robot-for-Smart-Restaurants/model_train/runs/classify/train/val_batch1_labels.jpg

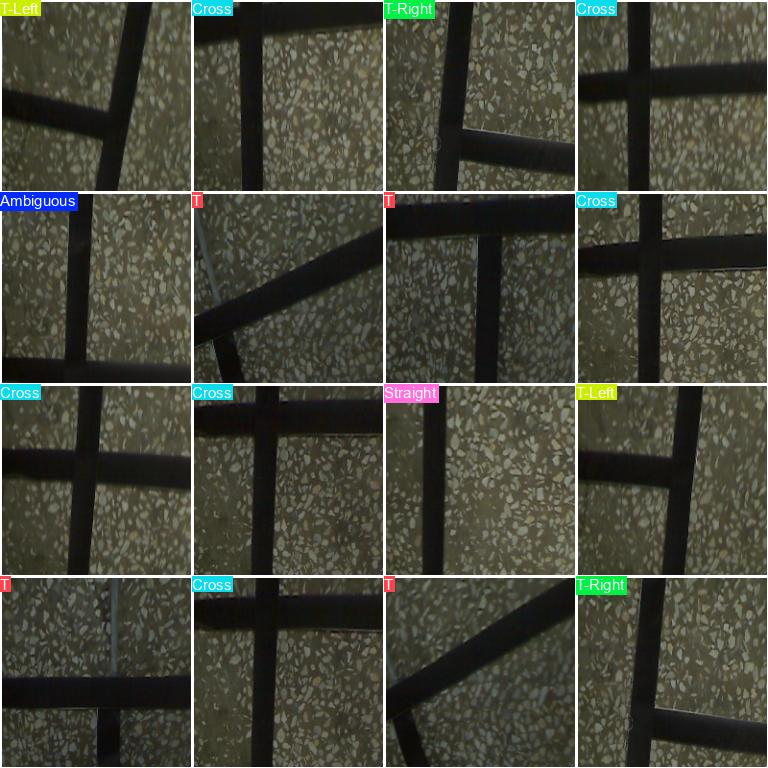
model_train/runs/classify/train/val_batch1_labels.jpg
