muneebahmed26301/Mobile-Robot-for-Smart-Restaurants/src/master_controller/map/graph2.png

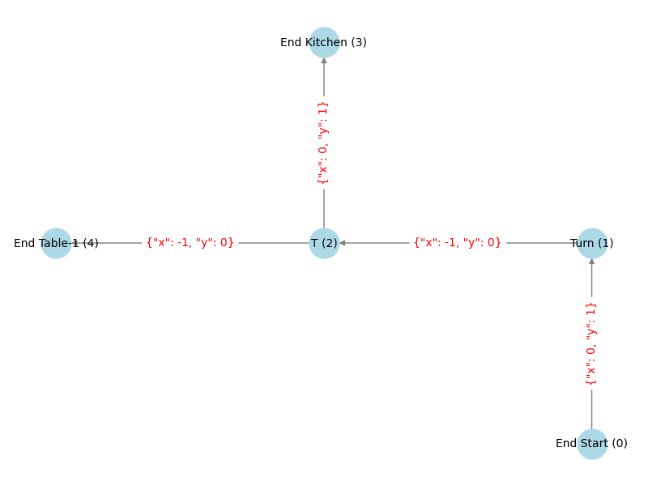
src/master_controller/map/graph2.png
