muneebahmed26301/Mobile-Robot-for-Smart-Restaurants/model_train/runs/classify/train/results.csv

epoch | time | train/loss | metrics/accuracy_top1 | metrics/accuracy_top5 | val/loss | lr/pg0 | lr/pg1 | lr/pg2
1 | 52.718 | 1.20548 | 0.94215 | 1 | 0.19893 | 0.00023672 | 0.00023672 | 0.00023672
2 | 105.745 | 0.21477 | 0.94923 | 1 | 0.16132 | 0.000427723 | 0.000427723 | 0.000427723
3 | 157.945 | 0.15986 | 0.96576 | 1 | 0.10858 | 0.000571602 | 0.000571602 | 0.000571602
4 | 210.076 | 0.12917 | 0.97048 | 1 | 0.08018 | 0.000501942 | 0.000501942 | 0.000501942
5 | 260.781 | 0.09971 | 0.97993 | 1 | 0.05318 | 0.000431256 | 0.000431256 | 0.000431256
6 | 311.6 | 0.08027 | 0.98701 | 1 | 0.03287 | 0.00036057 | 0.00036057 | 0.00036057
7 | 362.108 | 0.07339 | 0.99174 | 1 | 0.02455 | 0.000289884 | 0.000289884 | 0.000289884
8 | 418.658 | 0.04817 | 0.98937 | 1 | 0.03001 | 0.000219198 | 0.000219198 | 0.000219198
9 | 475.49 | 0.04222 | 0.99174 | 1 | 0.03015 | 0.000148512 | 0.000148512 | 0.000148512
10 | 529.438 | 0.03526 | 0.99055 | 1 | 0.02415 | 7.7826e-05 | 7.7826e-05 | 7.7826e-05
