muneebahmed26301/Mobile-Robot-for-Smart-Restaurants/model_train/runs/classify/train2/results.csv

epoch | time | train/loss | metrics/accuracy_top1 | metrics/accuracy_top5 | val/loss | lr/pg0 | lr/pg1 | lr/pg2
1 | 194.429 | 0.92938 | 0.95957 | 1 | 0.12418 | 0.00023747 | 0.00023747 | 0.00023747
2 | 437.134 | 0.20049 | 0.96834 | 1 | 0.09653 | 0.000456641 | 0.000456641 | 0.000456641
3 | 662.932 | 0.17133 | 0.97272 | 1 | 0.07406 | 0.000656963 | 0.000656963 | 0.000656963
4 | 887.44 | 0.14792 | 0.97954 | 1 | 0.07187 | 0.000629177 | 0.000629177 | 0.000629177
