muneebahmed26301/Mobile-Robot-for-Smart-Restaurants/model_train/runs/classify/train/results.png

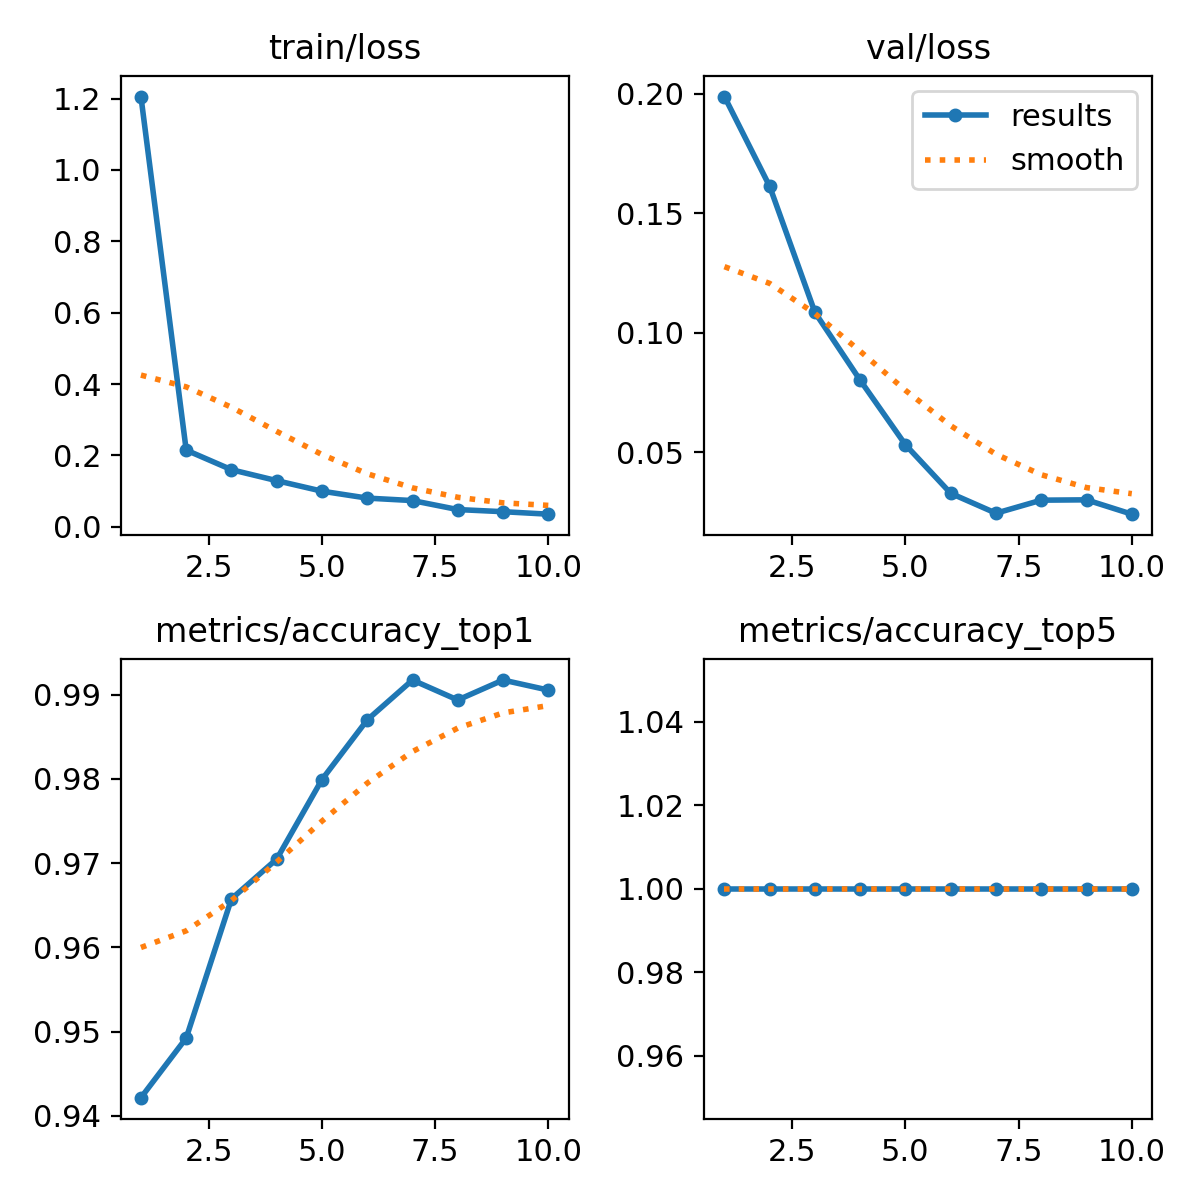
model_train/runs/classify/train/results.png
